chengmatt416/Keyboard/cad/out/fit_report.md

# STRIP/84 v0.4 fit report

Generated by `cad/build_case.py` from `design/strip84.json`. Every check intersects the printed parts with an envelope built from the real part's dimensions; PASS = zero overlapping volume.

| Check | Result | Note |
|---|---|---|
| 84 + 4 macro MX switches: housing + pins + 2 mm wiring vs case/plate | PASS | housing below plate 5.0, pins 3.3 |
| 88 keycaps (pressed → unpressed) vs bezel / lip | PASS | keycap gap to opening wall ≥ 1.77 mm |
| 4 stabiliser sets (housings + wire) vs case | PASS |  |
| 2 × EC11 body, pins and bushing vs case | PASS |  |
| 2 knobs vs case | PASS |  |
| 1.69" panel vs case | PASS |  |
| 1.69" module PCB vs case | PASS |  |
| Screen retainer vs case | PASS |  |
| Touch-bar cover glass vs pocket | PASS |  |
| Touch-bar LCD vs deck | PASS |  |
| Cassette vs case | PASS |  |
| Cassette vs LCD | PASS |  |
| ESP32-S3 board vs case | PASS |  |
| ESP32-S3 board vs sled | PASS |  |
| ESP32-S3 board vs screen module | PASS |  |
| ESP32-S3 board vs encoders | PASS |  |
| Knobs vs macro keycaps | PASS |  |
| Macro switch wiring vs encoders | PASS |  |
| Macro switch wiring vs screen module | PASS |  |
| ESP32-S3 board vs cassette | PASS |  |
| Sled vs case | PASS |  |
| USB-C plug shell vs rear wall | PASS | mated 6.0 mm |
| USB-C plug overmold (12.2 × 6.6) vs rear wall | PASS |  |
| MCP23017 perfboard (80 × 24, DIP sockets) vs case | PASS | free bay under the touch bar |
| MCP perfboard vs cassette | PASS |  |

## Key clearances

| Item | Value |
|---|---|
| Front row: switch pin tips → floor | 3.62 mm |
| Front row: room left for diodes / wire below pins | 3.62 mm (≥ 2.0 required) |
| Keytop height, front row / F-row (render envelope) | 30.8 / 35.0 mm |
| Case height front edge / rear edge | 20.9 / 27.9 mm |
| Case footprint | 366.1 × 159.1 mm |
| Typing angle | 2.5° |
| Keycap → opening wall gap | 1.77 mm per side |
| Touch-bar glass top vs bezel | flush (pocket depth = glass thickness) |

## Printed parts

| Part | Volume cm³ | Bounding box mm |
|---|---:|---|
| top_case | 193.0 | 366.1 × 159.1 × 25.4 |
| bottom_plate | 139.5 | 362.6 × 155.6 × 2.5 |
| touchbar_cassette | 9.4 | 354.6 × 24.8 × 4.0 |
| mcu_sled | 6.7 | 36.0 × 69.0 × 6.6 |
| screen_retainer | 1.9 | 45.3 × 40.1 × 3.7 |
| test_coupon | 16.7 | 112.0 × 44.0 × 8.0 |

## FDM split (256 mm bed)

Top-case seam follows key boundaries at x = 186.35, 186.35, 176.82, 181.59, 191.11, 243.50 (rows F→bottom).

| Part | Bounding box mm |
|---|---|
| top_case_L | 243.5 × 159.1 × 25.4 |
| top_case_R | 189.2 × 159.1 × 25.4 |
| bottom_plate_L | 148.3 × 155.6 × 2.5 |
| bottom_plate_R | 214.3 × 155.6 × 2.5 |
| touchbar_cassette_L | 177.3 × 24.8 × 4.0 |
| touchbar_cassette_R | 177.3 × 24.8 × 4.0 |
| mcu_sled | 36.0 × 69.0 × 6.6 |
| screen_retainer | 45.3 × 40.1 × 3.7 |
