chengmatt416/Keyboard/docs/STRIP84_Requirements_v0.3.md

# STRIP / 84 — 產品需求與規格

> **v0.3 · 2026-11-07 · 概念設計／選型中**  
> 依據上一版 `STRIP84_Product_Design.html` 的84鍵資料延伸，新增程式繪製的分解、俯視與側視圖。本文件不是可直接加工或投產的工程包。

## 1. 產品定義與目前狀態

一台75%概念配列的84鍵青軸機械鍵盤，具備獨立實體F1～F12、全寬圖形Touch Bar、側螢幕、旋鈕、USB-C與BLE，由同一顆ESP32控制。

Touch Bar必須能顯示可變圖案、文字、滑桿與狀態列。可接受單色或彩色圖形顯示；不接受固定背光圖示、純電容條或拼接螢幕作為同等替代。

**總預算要求仍為NT$3,000，完整規格尚未達成此預算。** 不含全寬Touch Bar的84鍵原型估算為NT$2,908，包含未確認目標價。合格全寬觸控總成、相容驅動與額外運稅尚無確定報價。

## 2. 圖面

三張圖均由隨附Python程式繪製，不使用照片、影像生成API或外部素材。另附可編輯SVG；PNG以300dpi中繼資料輸出。圖上的尺寸是設計目標或渲染假設，非加工公差。

| 圖面 | 尺寸 | 用途 |
|---|---:|---|
| 分解圖 | 3400 × 2700 px | 六個主要組件與共用電控關係 |
| 俯視圖 | 3400 × 2300 px | 鍵位、觸控列與平面尺寸 |
| 側視圖 | 3400 × 2200 px | 高度、傾角與堆疊包絡 |

### 2.1 分解圖

STRIP84 分解圖

### 2.2 俯視圖

STRIP84 俯視圖

### 2.3 側視圖

STRIP84 側視圖

單獨下載Markdown時，需一併保留相鄰的 `images/` 目錄；完整ZIP已包含全部檔案。

## 3. 硬性需求與驗收定義

| ID | 需求 | 可驗收行為 |
|---|---|---|
| R01 | 機械青軸 | 主鍵區與F排皆為MX相容機械clicky青軸，不用光軸／磁軸替代 |
| R02 | 實體F1～F12 | 12顆獨立按鍵，可直接送對應HID功能鍵，不需Fn |
| R03 | 單片全寬Touch Bar | 連續有效顯示區橫跨整機上緣，包含左側控制區上方，無螢幕拼接 |
| R04 | 可變圖形 | 任意重畫文字、圖示、滑桿、進度與狀態，不限預印圖示或段碼 |
| R05 | 連續觸控 | 至少單點X/Y座標，支援點選、拖曳、放開、取消 |
| R06 | 側螢幕 | 按鍵、圖層、旋鈕與電腦指令可更新資訊 |
| R07 | 同一ESP32 | 一顆ESP32-S3執行全部產品邏輯；允許顯示橋接、觸控與I/O周邊IC |
| R08 | 雙向通訊 | 電腦更新畫面／設定；鍵盤送HID按鍵或具名動作指令 |
| R09 | USB-C與BLE | USB資料與供電、BLE HID；基本鍵盤功能不需雲端 |
| R10 | 雙裝置切換 | A＝USB、B＝BLE預先連線，旋鈕一格切換輸入目標，避免每次重新配對 |
| R11 | 可編程 | 按鍵、圖層、巨集、Touch Bar元件及主機動作可改，設定可保存 |
| R12 | 總預算≤3000 | 必要材料、運費與小額備料皆計入，未知成本不能算0 |

R12目前未通過；其餘是需求與驗收規格，不是實機已通過的測試結果。

### 本版採用的設計選擇

- 75%概念配列、84鍵，含方向與導覽鍵，不含數字鍵盤區。
- 定位板＋手工焊接矩陣；熱插拔與客製全尺寸PCB不列為必要。
- USB 5V供電，不含鋰電池；切到BLE-B時可繼續由USB-A供電。
- 拔線後獨立BLE使用需另備合適5V電源，不假設免費附送電池。
- 兩台都用BLE為額外多連線需求，尚未納入本版驗證基準。
- 圖面鍵帽配色只是外觀提案；顯示色彩也尚未凍結。

## 4. 機構尺寸與座標

X由左向右、Y由後緣Touch Bar側往前緣、Z自桌面向上；單位mm。

### 4.1 平面配置

| 部位 | 設計目標 | 狀態 |
|---|---|---|
| 機身 | 365寬 × 170深 | 可能依面板外形調整 |
| 主鍵區 | X=53，Y=44；304.8 × 114.3 | 16u × 6u；鍵距19.05 |
| 左側控制區 | X=8，Y=44；約40 × 114.3 | 旋鈕、側螢幕與內部控制板 |
| 主鍵區與左區間距 | 約5 | X=48至53 |
| Touch Bar有效區 | X=8，Y=8；349 × 22 | 尚無合格可採購型號 |
| 上方蓋板示意 | X=4，Y=4；357 × 30 | 僅渲染包絡，不是現成面板尺寸 |
| 有效顯示區左右留邊 | 約8／側 | 仍需容納玻璃、固定、FPC |
| 側螢幕 | 1.69吋，240×280 | 模組外框與固定孔待實物確認 |
| USB-C開口 | 後側偏左 | 示意位置，需配合主控原生USB口 |

**全寬指有效顯示區。** 不能用整片蓋板遮住數片小屏，也不能把外形300mm、有效長度282mm的面板當成本版349mm目標。

### 4.2 側視高度假設

以下為了三張概念圖一致而設定，不是特定零件的原廠尺寸：

| 參數 | 渲染值 | 說明 |
|---|---:|---|
| 全機最高包絡目標 | ≤35 | 尚未驗證 |
| 腳墊 | 3 | 佈局假設 |
| 底板 | 2 | 材料／結構假設 |
| 定位板 | 1.5 | 需與軸及固定方式配合 |
| 定位板平面Y=0 | Z=20.5 | 幾何基準 |
| 定位板平面Y=170 | Z=13.5 | 幾何基準 |
| 定位板傾角 | 約2.36° | 高低差7／深度170 |
| 鍵頂相對板面的包絡 | +14.5 | 不是已選定軸／鍵帽的尺寸 |
| 前排鍵頂包絡 | 約28.5 | 由板面及鍵帽包絡推算 |
| F排後緣鍵頂包絡 | 約33.2 | 由板面及鍵帽包絡推算 |
| Touch Bar玻璃上表面 | 約Z=33 | 後部抬高平台，靠近F排鍵頂 |
| Touch Bar總成厚度圖示 | 3 | 佔位；實際厚度與控制板空間待定 |

```text
Z_plate(Y) = 20.5 - (7 / 170) × Y
```

選定青軸、鍵帽、衛星軸、面板與控制板後，必須重新量測高度、開孔、干涉及公差，再產出製造模型。爆炸圖的展示間距不代表實際裝配距離。

## 5. 配列與組件

### 5.1 外觀六排

| 外觀排 | 鍵數 | 由左至右 |
|---|---:|---|
| 1 | 16 | Esc · F1 · F2 · F3 · F4 · F5 · F6 · F7 · F8 · F9 · F10 · F11 · F12 · PrtSc · Ins · Pause |
| 2 | 15 | Grave · 1 · 2 · 3 · 4 · 5 · 6 · 7 · 8 · 9 · 0 · - · = · Backspace · Del |
| 3 | 15 | Tab · Q · W · E · R · T · Y · U · I · O · P · [ · ] · Backslash · PgUp |
| 4 | 14 | Caps · A · S · D · F · G · H · J · K · L · ; · ' · Enter · PgDn |
| 5 | 14 | Shift · Z · X · C · V · B · N · M · , · . · / · RShift · Up · End |
| 6 | 10 | Ctrl · Win · Alt · Space · RAlt · Fn · RCtrl · Left · Down · Right |

合計84鍵。Fn作額外圖層，不取代實體F1～F12。

| 特殊鍵帽 | 規格 |
|---|---|
| 右Shift | 1.75u |
| Space | 6.25u |
| Backspace | 2u |
| Enter／左Shift | 2.25u |
| 底排修飾鍵 | 1u及1.25u混用 |
| 衛星軸 | 6.25u空白×1；2u級規格供Backspace／Enter／左Shift共3組 |

鍵帽、衛星軸與定位板必須核對同一配列及安裝方式，不能只看「支援84鍵」。

### 5.2 分解圖中的六組件

| 圖號 | 組件 | 構成與職責 | 未定項目 |
|---|---|---|---|
| 01 | 全寬圖形觸控總成 | 蓋板、觸控感測層、像素顯示 | 型號、尺寸、厚度、FPC與驅動 |
| 02 | 84顆鍵帽 | F排、文字鍵、導覽與修飾鍵 | 高度與配列相容性 |
| 03 | 84顆機械青軸 | clicky機械輸入 | 品牌、腳數與外形 |
| 04 | 定位板與上框 | 固定軸、衛星軸、螢幕與旋鈕區 | 開孔、材料、公差 |
| 05 | 配線與共用電控 | 手工矩陣、二極體、S3、MCP×2、側TFT、EC11及候選顯示橋接 | 逐網配線、供電、實際零件位置 |
| 06 | 底殼與腳墊 | 保護、固定、絕緣與止滑 | 螺柱、加工與強度 |

圖上的配線為示意，未完成逐網佈線；顯示橋接區也是佔位，不代表已有相容可購總成。

## 6. 電控與原型接線

| 元件 | 基準規格／職責 |
|---|---|
| 主控 | ESP32-S3 N16R8：16MB Flash、8MB PSRAM |
| 矩陣 | 7×12＝84鍵，每鍵一顆二極體 |
| I/O擴充 | MCP23017×2，I²C位址0x20／0x21 |
| 側屏 | 1.69吋、240×280、ST7789V系列SPI模組 |
| 旋鈕 | EC11 A/B相＋按壓 |
| Touch Bar | 像素式圖形面板＋連續座標觸控；料號TBD |
| 顯示驅動 | 依面板選擇；S3沒有原生MIPI DSI |

一顆ESP32-S3管理全機狀態、按鍵路由、GUI與通訊。周邊IC可以協助掃描、觸控、顯示與供電，不以第二顆應用主控分別執行兩套邏輯。

### 6.1 原型腳位表

沿用v0.2；核對實際開發板原理圖後才能接線。此表不是全寬版最終接腳表。

| 功能 | 接腳／連接 |
|---|---|
| 原生USB D−／D+ | GPIO19／GPIO20，使用開發板原生USB口 |
| I²C SDA／SCL | GPIO8／GPIO9，3.3V邏輯 |
| 側TFT MOSI／SCLK | GPIO11／GPIO12 |
| 側TFT DC／CS／RST | GPIO13／GPIO14／GPIO15 |
| 側TFT BL | GPIO16可作PWM訊號；不能假設可直接供背光負載 |
| EC11 A／B／SW | GPIO4／GPIO5／GPIO6 |
| MCP #0 | 0x20：GPA0～6→R0～R6，GPB0～7→C0～C7 |
| MCP #1 | 0x21：GPA0～3→C8～C11 |
| 全寬顯示／觸控 | 待面板介面、電壓與GPIO盤點後分配 |

接線條件：

- I²C上拉需納入模組自帶電阻；位址腳與RESET不可懸空。
- 每顆MCP旁預留100nF去耦，入口另放適當儲能電容。
- 掃描時僅目前row輸出低，其他row高阻；column啟用上拉。
- 二極體方向為column → 開關 → 二極體 → row，**條紋陰極朝row**。
- 背光與面板電源按實際規格設計，不直接套用GPIO供電能力。
- 若顯示橋接需要大量RGB接腳，須重新分配腳位並驗證頻寬。

### 6.2 完整電氣矩陣

R0～R6不等於外觀六排。`design.json`包含每顆鍵的外觀u座標、寬度與電氣R/C。

| 電氣列 | C0 | C1 | C2 | C3 | C4 | C5 | C6 | C7 | C8 | C9 | C10 | C11 |
|---|---|---|---|---|---|---|---|---|---|---|---|---|
| R0 | Esc | F1 | F2 | F3 | F4 | F5 | F6 | F7 | F8 | F9 | F10 | F11 |
| R1 | F12 | PrtSc | Ins | Pause | Grave | 1 | 2 | 3 | 4 | 5 | 6 | 7 |
| R2 | 8 | 9 | 0 | - | = | Backspace | Del | Tab | Q | W | E | R |
| R3 | T | Y | U | I | O | P | [ | ] | Backslash | PgUp | Caps | A |
| R4 | S | D | F | G | H | J | K | L | ; | ' | Enter | PgDn |
| R5 | Shift | Z | X | C | V | B | N | M | , | . | / | RShift |
| R6 | Up | End | Ctrl | Win | Alt | Space | RAlt | Fn | RCtrl | Left | Down | Right |

## 7. Touch Bar圖形與觸控

| 元件 | 必要行為 |
|---|---|
| 圖示按鈕 | 圖案／標籤可依App、圖層或電腦指令變更 |
| 滑桿 | 顯示軌道、滑塊、數值，支援點選與連續拖曳 |
| 狀態列 | 可更新文字、圖示、連線／工作狀態 |
| 進度條 | 由主機數值或本機狀態更新 |
| 頁面／圖層 | 不同版面可保存，切換不影響實體F排存在 |

觸控流程：

1. 讀取連續X/Y座標並轉換到UI座標。
2. 按下時命中元件，鎖定該次觸控的元件與主機目標。
3. 拖出元件邊界時仍維持原拖曳，數值限制於合法範圍。
4. 放開／取消時終止拖曳並送最後狀態。
5. 切換主機時取消舊手勢與連發，等待手指放開後才能對新主機開始操作。
6. 至少單點觸控；多點為可選項，選型前不宣稱支援。

更新與排程：

- 日常只傳數值、文字或圖示ID，由鍵盤繪圖；圖示可預存Flash。
- 不把BLE當全畫面串流，顯示刷新不得阻塞鍵盤事件。
- 實際更新率與回饋延遲量測後定稿，不預先宣稱60fps。
- video-mode面板仍需持續符合掃描時序；少改UI不代表面板頻寬同步降低。
- 單色圖形OLED／LCD也可實現上述介面，前提是全寬尺寸與驅動可取得。

## 8. 雙裝置、旋鈕與供電

| 目標 | 連線 | 按鍵 | 雙向資料 |
|---|---|---|---|
| A | USB-C | USB HID鍵盤／媒體鍵 | CDC或等效資料通道 |
| B | BLE | HID over GATT | 自訂GATT服務 |

兩條連線保持存在，但只有目前選中目標收到操作。USB-A可在操作BLE-B時持續供電。

EC11一完整格切A／B；長按約2秒進BLE配對是本版設計選擇。新目標離線時顯示離線，不把輸入改送別處。

切換順序：

1. 對舊目標釋放一般鍵、修飾鍵與媒體鍵。
2. 取消未完成巨集、連發與觸控拖曳。
3. 切路由並載入新裝置UI。
4. 切換時按住的鍵需放開再按，才送往新目標。
5. 量測已連線、睡眠、斷線及重連情境後，再訂切換延遲指標。

「立即」的方向是持續連線後切路由，不是每次重新配對；尚無實機延遲數據。

供電基準為USB 5V，邏輯3.3V。全寬顯示總成的穩壓、背光、峰值電流與USB供電能力必須獨立核對；不可把未知面板直接掛在開發板穩壓器上。本版不含電池及充電系統。

## 9. 可編程與電腦端

不需電腦常駐程式的功能：

- 一般打字、F1～F12、媒體鍵。
- 本機圖層、組合鍵與延遲巨集。
- 按鍵／旋鈕／觸控觸發本機UI。
- 載入已保存的裝置設定。

需要電腦程式的功能：

- 偵測前景App並切換Touch Bar版面。
- 提供CPU、編譯、播放與專案狀態。
- 把具名action對應到使用者設定的程式或命令。
- 上傳、修改與同步設定。

USB與BLE共用訊息語意。USB可用換行分隔JSON；BLE按MTU分段後重組，帶ID與ACK。圖示資源優先預載。

```json
{
  "v": 1,
  "id": 42,
  "op": "ui.patch",
  "profile": "usb-a",
  "widgets": {
    "volume": {"value": 64},
    "build": {"value": 42, "state": "running"},
    "action1": {"icon": "terminal", "text": "Terminal"}
  }
}
```

鍵盤送出的具名動作例如 `project.build`。以上是規格草案，不是已完成的韌體或常駐程式。

## 10. 材料與預算

沿用v0.2價格研究與估算，**本次未重新確認商家庫存與結帳價**。目標價不代表正式報價，搜尋入口不代表已選定商品。

前次查閱時，NT$295的S3參考來源與NT$25的EC11來源顯示售完，需另確認替代件；90顆青軸NT$530仍是目標估價，未取得所選規格的獨立結帳價。

| 項目 | 數量 | 小計 | 價格狀態 | 購買／查詢 |
|---|---:|---:|---|---|
| ESP32-S3 N16R8 開發板 | 1 | NT$295 | 已見標價，庫存／規格另確認 | [商品頁](https://www.jmaker.com.tw/products/esp32-s3) |
| MX 相容青軸，90 顆裝 | 1 | NT$530 | 估價／採購目標 | [多規格賣場](https://www.ruten.com.tw/item/22623825855604/) |
| 支援 75% 的 MX 鍵帽組 | 1 | NT$280 | 估價／採購目標 | [搜尋入口](https://www.ruten.com.tw/find/?q=75%25%20%E9%8D%B5%E5%B8%BD%201.75u%20shift%206.25u) |
| 板裝衛星軸一組 | 1 | NT$90 | 估價／採購目標 | [搜尋入口](https://www.ruten.com.tw/find/?q=%E6%9D%BF%E8%A3%9D%20%E8%A1%9B%E6%98%9F%E8%BB%B8%206.25u%202u) |
| 75% 定位板／製作預留 | 1 | NT$230 | 估價／採購目標 | [搜尋入口](https://www.ruten.com.tw/find/?q=75%25%2084%E9%8D%B5%20%E5%AE%9A%E4%BD%8D%E6%9D%BF) |
| 1N4148 DO-35，100 顆 | 1 | NT$50 | 已見標價，庫存／規格另確認 | [商品頁](https://jin-hua.com.tw/page/product/show.aspx?lang=TW&num=12896) |
| MCP23017 直插式 IC | 2 | NT$320 | 已見標價，庫存／規格另確認 | [賣方價目表](https://piepie.com.tw/purchase) |
| 1.69 吋 ST7789V SPI 模組 | 1 | NT$145 | 已見標價，庫存／規格另確認 | [分類頁](https://www.icshop.com.tw/categories/tft) |
| EC11 帶按壓編碼器 | 1 | NT$25 | 已見標價，庫存／規格另確認 | [商品頁](https://www.icshop.com.tw/products/368011000377) |
| EC11 相容旋鈕帽 | 1 | NT$13 | 已見標價，庫存／規格另確認 | [分類頁](https://www.icshop.com.tw/categories/encoders-and-knobs) |
| 接線、洞洞板、插座與被動件 | 1 | NT$160 | 估價／採購目標 | [搜尋入口](https://www.ruten.com.tw/find/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) |
| 簡易外殼、螺絲與腳墊 | 1 | NT$330 | 估價／採購目標 | [詢價入口](https://www.ruten.com.tw/find/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) |
| USB-C 資料傳輸線 | 1 | NT$70 | 估價／採購目標 | [搜尋入口](https://www.ruten.com.tw/find/?q=USB%20C%20%E8%B3%87%E6%96%99%E5%82%B3%E8%BC%B8%E7%B7%9A) |
| 各賣場運費合計預留 | 1 | NT$220 | 估價／採購目標 | 預留 |
| 備料與小額重做預留 | 1 | NT$150 | 估價／採購目標 | 預留 |
| 單片全寬圖形觸控面板總成（單色或彩色） | 1 | 待報價 | 無合格料件報價 | [參考件／詢價](https://tailorpixels.com/product/11-6-inch-narrow-long-lcd-mipi-140x1920-with-touch/) |
| 相容的顯示橋接／控制板 | 1 | 待報價 | 無合格料件報價 | [技術參考](https://www.solomon-systech.com/product/ssd2828) |
| 全寬面板額外運費／稅費 | 1 | 待報價 | 無合格料件報價 | 待報價 |

| 預算結果 | 金額 |
|---|---:|
| 不含全寬Touch Bar的原型估算，含既定運費及備料 | NT$2,908 |
| 預算上限 | NT$3,000 |
| 留給全寬總成、驅動與額外運稅 | NT$92 |
| 完整目標總價 | **尚無法確認** |

若主控改NT$400備選、青軸組改NT$588，原型估算為NT$3,071，未含Touch Bar便會超支。

工具假設可借用烙鐵、電表與基本手工具；若需購買，也應加入總預算。不含人工、電池、RGB鍵盤燈效、CNC鋁殼或客製熱插拔PCB。

合格Touch Bar需要單片全寬圖形顯示、完整連續觸控、相容驅動、初始化／時序／電源／FPC資料及樣品到手價。目前參考到的約282mm有效長度面板不符合本版349mm目標；候選橋接IC也不能當作已確認可用整板。

## 11. 製作與驗收

| 階段 | 工作 | 通過條件 |
|---|---|---|
| 0 | 面板／觸控／驅動選型與詢價 | 尺寸、功能、相容性及總預算均有依據 |
| 1 | S3原生USB與BLE HID | A／B各自可輸入，並能持續雙連線 |
| 2 | EC11與路由 | 反覆切換、按住修飾鍵切換也不卡鍵 |
| 3 | 2×2矩陣試片 | 二極體方向、去抖與組合鍵正確 |
| 4 | 擴充84鍵 | 所有鍵正確，F1～F12直接輸出 |
| 5 | 側屏與資料通道 | 主機／按鍵／圖層可更新畫面 |
| 6 | 全寬圖形觸控 | 可變圖案、連續滑桿、狀態列與動作正常 |
| 7 | 機構與電源驗證 | 無干涉，最大負載不掉電／重啟 |
| 8 | 外殼加工 | 取得實際尺寸、公差與加工價後下單 |

驗收清單：

- [ ] 實體84鍵及F1～F12正確，皆為機械青軸。
- [ ] Touch Bar全寬無拼接，為可重畫像素圖形。
- [ ] 圖案、文字、滑桿、狀態列均可更新。
- [ ] 拖出元件及切主機時，手勢可以正確結束／取消。
- [ ] 同一ESP32控制兩片顯示及全部輸入／連線。
- [ ] USB-A與BLE-B保持連線，旋鈕切換不重配對。
- [ ] 睡眠、斷線、切換及重連均不造成卡鍵。
- [ ] 最大顯示負載下打字穩定，量測輸入及觸控回饋。
- [ ] 量測峰值電流、壓降、溫度，完成機構／接頭／天線淨空檢查。
- [ ] 所有必要零件及運費有確認價，合計不超過NT$3,000。

本次沒有宣稱已完成上述實機測試。

## 12. 已知未定項目

| 項目 | 影響 |
|---|---|
| 合格全寬面板與觸控控制器 | 外形、有效區、厚度、解析度與觸控能力未凍結 |
| 顯示橋接與供電 | GPIO、驅動、頻寬、電流與電源設計未驗證 |
| 具體主控板版型 | USB位置、外形與部分腳位可能不同 |
| 青軸／鍵帽／衛星軸實物 | 圖中高度及開孔仍需實物配合檢查 |
| 完整原理圖、Gerber、STL、DXF | 尚未交付；PNG／SVG不是製造檔 |
| 可燒錄韌體與常駐程式 | 尚未交付；此為行為與介面規格 |
| 完整3000元BOM | 尚未成立，圖面不代表採購問題已解決 |

## 13. 交付、重現與參考

| 路徑 | 內容 |
|---|---|
| `STRIP84_Requirements.md` | 本文件 |
| `images/*.png` | 分解圖、俯視圖、側視圖 |
| `vectors/*.svg` | 對應的可編輯向量版本 |
| `design.json` | 尺寸、84鍵位、電氣矩陣及BOM |
| `render_strip84.py` | 繪圖來源程式 |
| `README.md` | 執行說明 |

重現：

```bash
python -m pip install "Pillow>=10.1"
python render_strip84.py
```

需要Python3.10+、Pillow10.1+與標準函式庫。程式從同目錄的 `design.json` 讀取資料，不需網路、瀏覽器或圖片生成API；字型依作業系統可能略有差異。

既有技術研究的主要來源：

- [ESP32-S3官方資料表](https://documentation.espressif.com/esp32_s3_datasheet_en.pdf)
- [Espressif USB Device Stack](https://docs.espressif.com/projects/esp-usb/en/latest/esp32s3/usb_device.html)
- [Espressif BLE HID範例](https://github.com/espressif/esp-idf/blob/master/examples/bluetooth/esp_hid_device/README.md)
- [Microchip MCP23017](https://www.microchip.com/en-us/product/mcp23017)
- [Solomon Systech SSD2828](https://www.solomon-systech.com/product/ssd2828)
- [Tailor Pixels長條面板參考件](https://tailorpixels.com/product/11-6-inch-narrow-long-lcd-mipi-140x1920-with-touch/)
- [WINSTAR圖形OLED觸控模組](https://www.winstar.com.tw/products/oled-module/oled-touch-display.html)
