chengmatt416/Keyboard/docs/STRIP84_Purchase_Status.md

# STRIP / 84 — 採購進度

更新日期：2026-11-08。依使用者回報：「螺絲買了，青軸買了，側螢幕買了，awg線買了」。已購項目不再列入待購；實際型號、數量、成交價與到貨狀態尚未提供，不推定已完成規格或實物驗證。

## 已購

| 項目 | 紀錄 | 設計需求／後續核對 |
|---|---|---|
| 螺絲／五金 | 已回報購買螺絲；未提供逐項明細，不推定所有螺帽與嵌件均已買足 | M3×8沉頭17支、M2×6自攻9支、M3六角螺帽2顆、M3熱熔螺母15顆＋試片備料。先核對已購明細，不重複下單。 |
| 青軸 | 已購 | 主鍵84＋巨集4，共需88顆MX相容青軸；實購型號與數量待核。 |
| 側螢幕 | 已購 | 原設計為1.69吋、240×280、SPI、ST7789V系列模組；以實購料號核對接腳、電壓、外框與固定方式。 |
| AWG線 | 已購 | 線規、線長及含絕緣外徑待核；用於矩陣／訊號配線，不再另購前版建議的整捲線。 |

## 尚未回報購買的核心零件

| 零件 | 設計需求 |
|---|---|
| ESP32-S3 | N16R8開發板1片，須有原生USB及所需GPIO，核對板型與供電。 |
| I²C擴充 | MCP23017模組2片，可分別設定0x20／0x21。 |
| 旋鈕／編碼器 | EC11帶按壓、20mm軸長2顆。 |
| 旋鈕帽 | 2顆，軸孔與EC11軸型匹配。 |
| 衛星軸 | 板裝6.25u 1組、2u 3組。 |
| 鍵帽 | 共88顆，保留原全金屬及完整配列要求；台灣出貨的完整合格貨源尚未確認。 |

「尚未回報」不代表使用者沒有。剩餘採購維持台灣本土出貨，優先同店合單，並比較商品加運費的實付成本；不再把已購的螺絲、青軸、側螢幕或AWG線列入新訂單。

## 其他必要材料與未完成項目

- 矩陣二極體84顆、USB資料線1條尚未回報已有；已有合用材料即可沿用。
- I²C上拉、RESET偏壓與去耦依實際MCP模組配置決定是否補件，避免重複買。
- 螺帽及熱熔嵌件是否已包含在五金訂單，依實購明細核對後才補缺項。
- 外殼／定位結構、全寬Touch Bar總成及韌體仍屬未完成項目，未因本次已購回報而取消。

目前沒有實際成交價與運費，不填已支出或剩餘實付總額。尺寸與機構需求對照[設計參數](../design/strip84.json)及[需求文件](STRIP84_Requirements_v0.3.md)。
