chengmatt416/Keyboard/cad/out/step/STRIP84_assembly.step

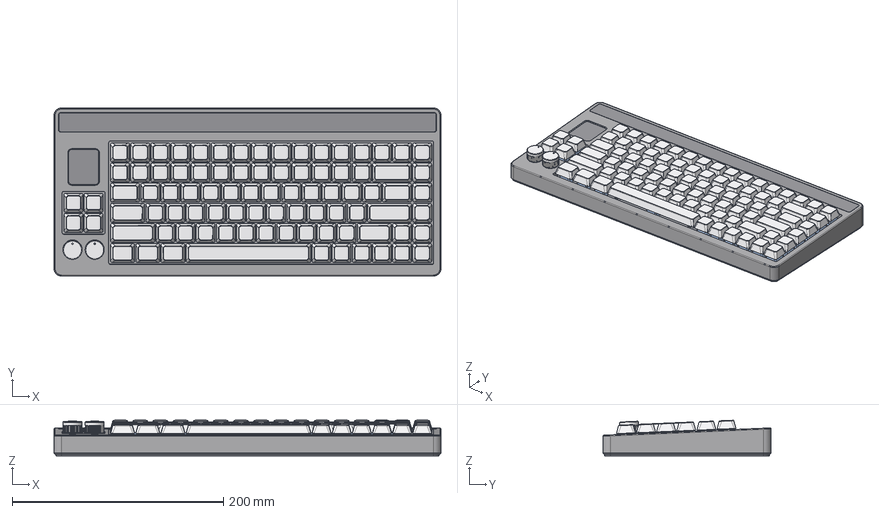
[picture p8: CAD file, 2026-11-08]
cad/out/step/STRIP84_assembly.step
366.0 x 159.0 x 33.6 mm
top_case_part
bottom_plate_part
touchbar_cassette_part
mcu_sled_part
screen_retainer_part
touchbar_glass_part
touchbar_lcd_envelope_part
side_screen_panel_part
side_screen_pcb_part
esp32s3_board_part
ec11_part
switch_00_part
keycap_00_part x 77
switch_01_part
switch_02_part
switch_03_part
switch_04_part
switch_05_part
switch_06_part
switch_07_part
switch_08_part
switch_09_part
switch_10_part
switch_11_part
switch_12_part
switch_13_part
switch_14_part
switch_15_part
switch_16_part
switch_17_part
switch_18_part
switch_19_part
switch_20_part
switch_21_part
switch_22_part
switch_23_part
switch_24_part
switch_25_part
switch_26_part
switch_27_part
switch_28_part
switch_29_part
keycap_29_part
switch_30_part
switch_31_part
keycap_31_part x 2
switch_32_part
switch_33_part
switch_34_part
switch_35_part
switch_36_part
switch_37_part
switch_38_part
switch_39_part
switch_40_part
switch_41_part
switch_42_part
switch_43_part
switch_44_part
switch_45_part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
