chengmatt416/Keyboard/cad/out/step/test_coupon.step

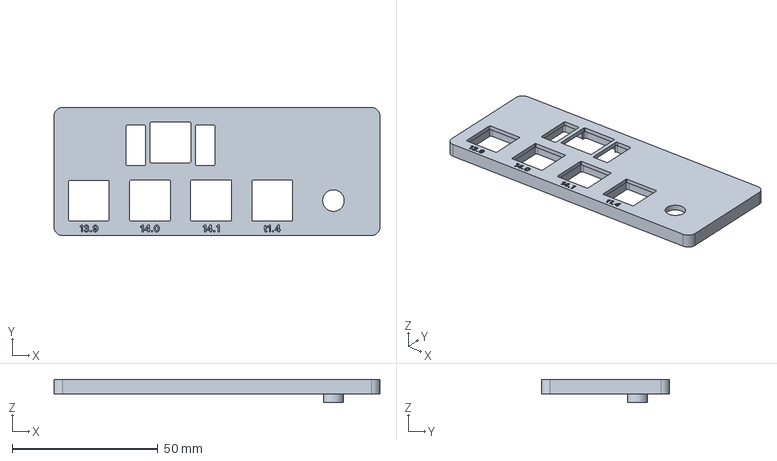
[picture p9: CAD file, 2026-11-08]
cad/out/step/test_coupon.step
112.0 x 44.0 x 8.00 mm
