chengmatt416/Keyboard/cad/out/stl/fdm/top_case_L.stl

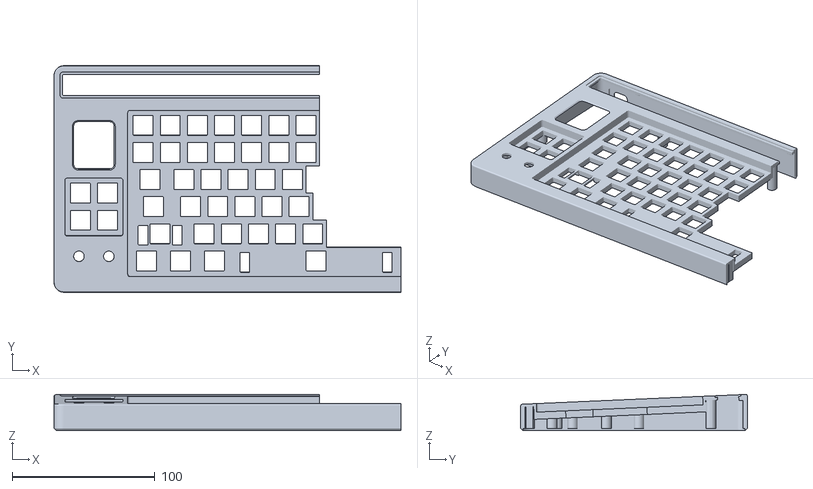
[picture p10: CAD file, 2026-11-08]
cad/out/stl/fdm/top_case_L.stl
243.5 x 159.0 x 25.4
