chengmatt416/Keyboard/cad/out/stl/mjf/bottom_plate.stl

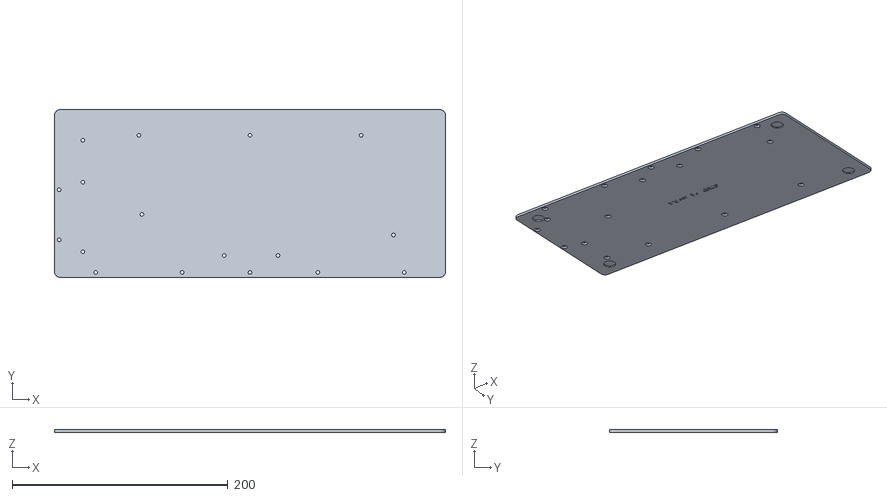
[picture p11: CAD file, 2026-11-08]
cad/out/stl/mjf/bottom_plate.stl
362.6 x 155.6 x 2.50
