chengmatt416/Keyboard/cad/out/step/screen_retainer.step

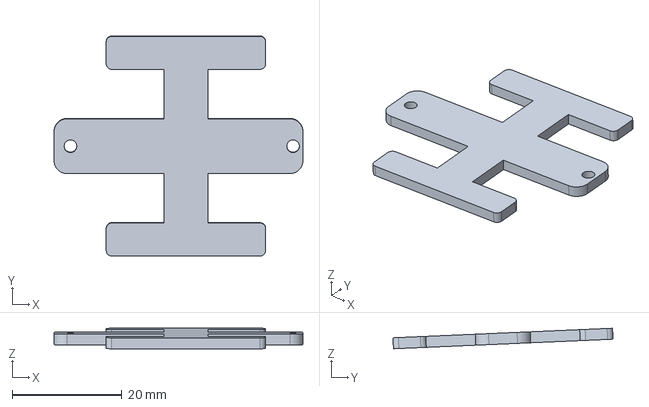
[picture p12: CAD file, 2026-11-08]
cad/out/step/screen_retainer.step
45.3 x 40.0 x 3.74 mm
