chengmatt416/Keyboard/cad/out/stl/fdm/touchbar_cassette_R.stl

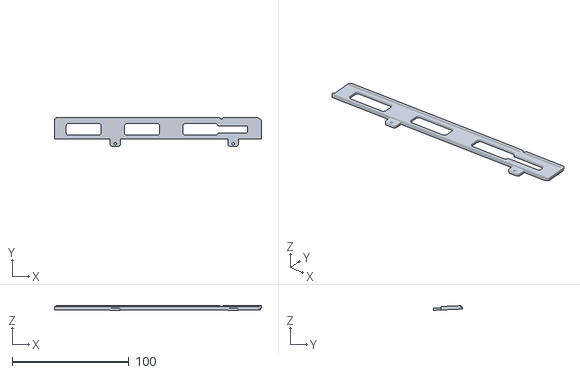
[picture p13: CAD file, 2026-11-08]
cad/out/stl/fdm/touchbar_cassette_R.stl
177.3 x 24.8 x 4.02
