chengmatt416/Keyboard/cad/out/stl/mjf/mcu_sled.stl

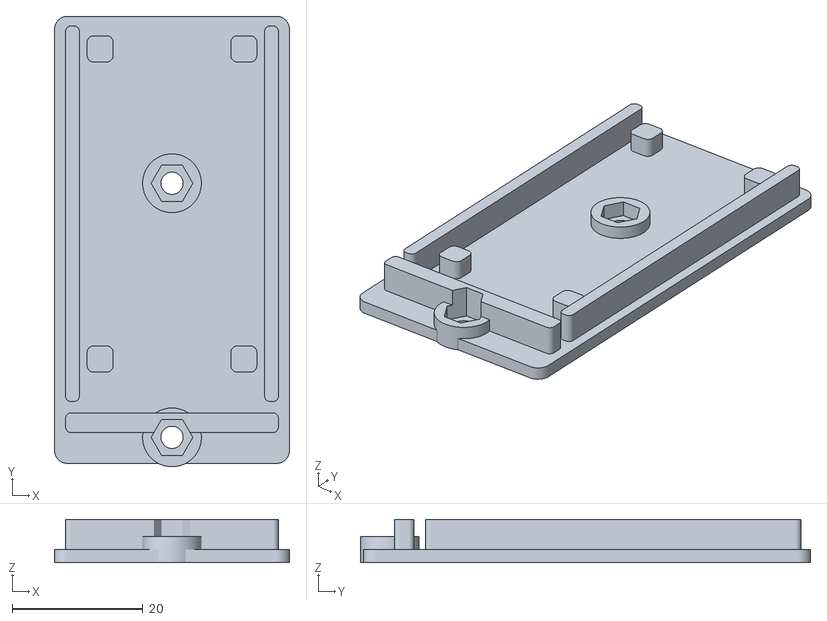
[picture p14: CAD file, 2026-11-08]
cad/out/stl/mjf/mcu_sled.stl
36.0 x 69.0 x 6.60
