chengmatt416/Keyboard/cad/out/step/top_case.step

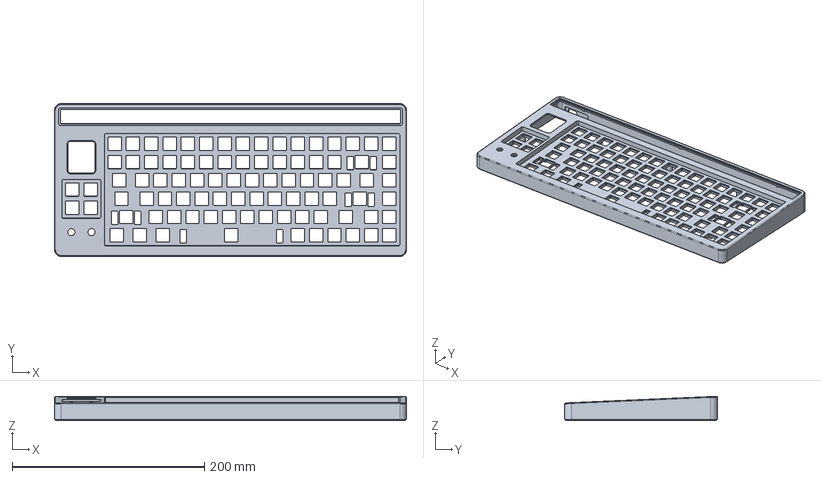
[picture p15: CAD file, 2026-11-08]
cad/out/step/top_case.step
366.0 x 159.0 x 25.4 mm
