chengmatt416/Keyboard/cad/out/stl/fdm/bottom_plate_R.stl

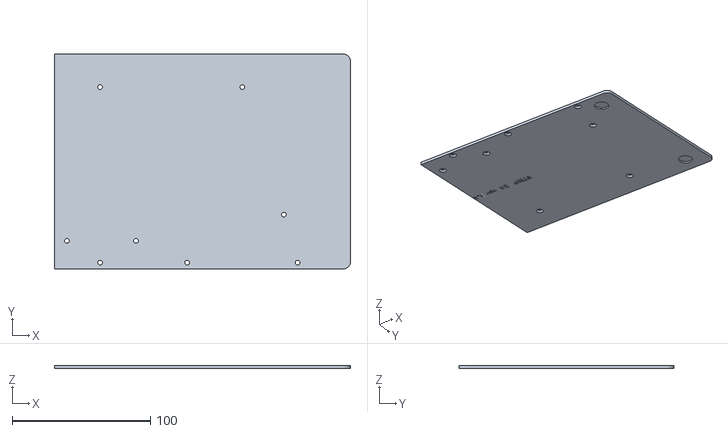
[picture p16: CAD file, 2026-11-08]
cad/out/stl/fdm/bottom_plate_R.stl
214.3 x 155.6 x 2.50
