chengmatt416/Keyboard/cad/out/stl/mjf/touchbar_cassette.stl

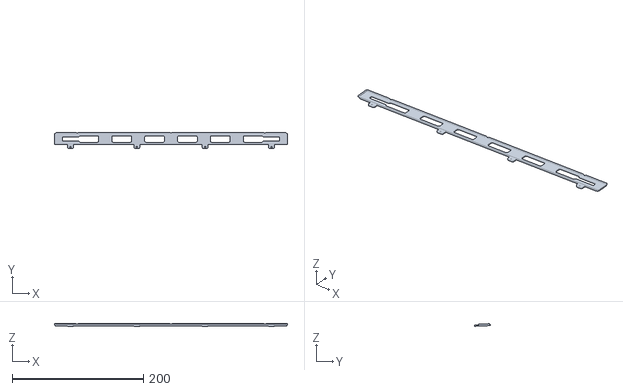
[picture p17: CAD file, 2026-11-08]
cad/out/stl/mjf/touchbar_cassette.stl
354.6 x 24.8 x 4.02
