chengmatt416/Keyboard/cad/out/stl/fdm/bottom_plate_L.stl

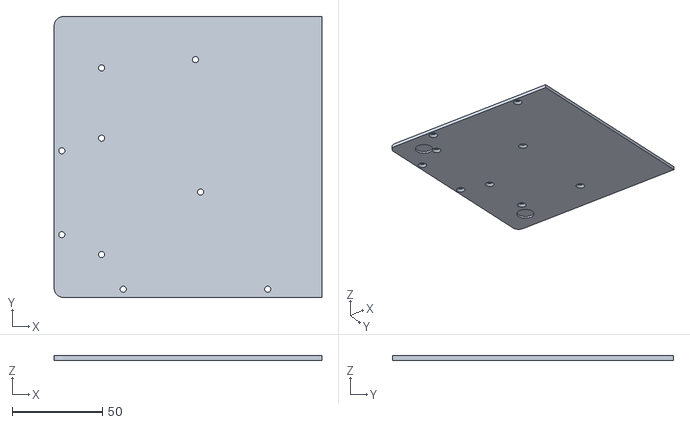
[picture p18: CAD file, 2026-11-08]
cad/out/stl/fdm/bottom_plate_L.stl
148.3 x 155.6 x 2.50
