chengmatt416/Keyboard/cad/out/stl/fdm/top_case_R.stl

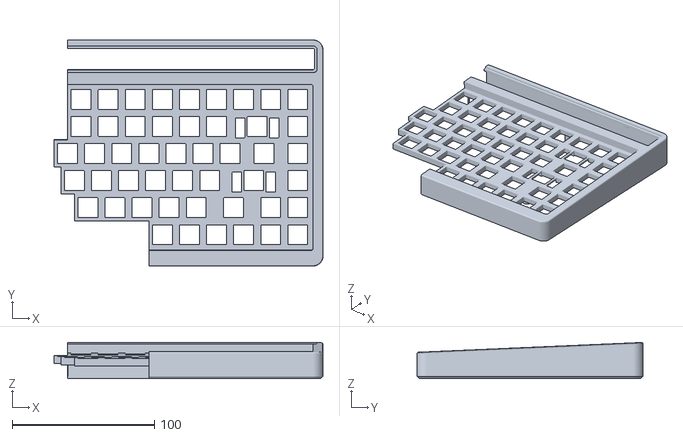
[picture p19: CAD file, 2026-11-08]
cad/out/stl/fdm/top_case_R.stl
189.2 x 159.0 x 25.4
