chengmatt416/Keyboard/(list of files, cad)

Other CAD files:
cad/out/stl/mjf/top_case.stl
cad/out/step/mcu_sled.step
cad/out/stl/mjf/screen_retainer.stl
cad/out/step/bottom_plate.step
cad/out/stl/fdm/touchbar_cassette_L.stl
cad/out/step/touchbar_cassette.step
cad/out/stl/fdm/screen_retainer.stl
cad/out/stl/test_coupon.stl
