chengmatt416/Keyboard/(commit log)

2026-11-08 Add STRIP/84 v0.4 parametric enclosure, fit checks and render pipeline (WIP)
    Claude-Session: https://claude.ai/code/session_01WhG3wk1YVv3RGpLubJZ2Nq
    [STRIP84_assembly.step, bottom_plate.step, bottom_plate.stl, bottom_plate_L.stl, bottom_plate_R.stl, mcu_sled.step, mcu_sled.stl, screen_retainer.step]
2026-11-08 Add section figure, docs, FDM split and smaller assembly STEP
    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
    [STRIP84_assembly.step, bottom_plate.step, bottom_plate_L.stl, bottom_plate_R.stl, mcu_sled.step, screen_retainer.step, test_coupon.step, top_case.step]
2026-11-08 Control column: two encoders and 2x2 macro keys
    Left column is now screen, 2x2 MX macro keys (own opening and
    integrated plate, wired to MCP23017 #1 GPA4-7) and two side-by-side
    EC11 knobs (second one on GPIO1/2, push on MCP #1 GPB0). Bosses and
    screen retainer moved to clear the new parts; 25/25 fit checks pass.
    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
    [STRIP84_assembly.step, bottom_plate.step, bottom_plate.stl, bottom_plate_L.stl, bottom_plate_R.stl, mcu_sled.step, screen_retainer.step, screen_retainer.stl]
2026-11-08 Slim the Touch Bar: 18 mm cover glass, 349 x 12 active area
    The rear band shrinks with it, so the case goes from 171 to 159 mm
    deep. Display ledge 1.5 mm, cassette bosses, feet and the MCP23017
    perfboard bay moved to suit; 25/25 fit checks pass.
    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
    [STRIP84_assembly.step, bottom_plate.step, bottom_plate.stl, bottom_plate_L.stl, bottom_plate_R.stl, mcu_sled.step, mcu_sled.stl, screen_retainer.step]
